SanjayG-xls/4-Mode-Embedded-Voice-Transformation-System-Using-STM32F4VE/modetesting.ioc

Mcu.UserName=STM32F407VETx
PA1.Signal=ADCx_IN1
PB12.Signal=I2S2_WS
PB13.Signal=I2S2_CK
PB15.Signal=I2S2_SD
