SanjayG-xls/4-Mode-Embedded-Voice-Transformation-System-Using-STM32F4VE/(notices)

Notices in the files:
README.md:
License: MIT
